greggdaug/RP_2port_VNA/README.md

# RP_2port_VNA
Documentation for Red Pitaya 2-port VNA / SDR tranceiver.
Matlab files are provided for 1-port cal and dut, and 2-port cal and dut. 2-port cal is under construction.
Word document contains original write-up submitted to QST.
Powerpoint document contains pictures for write-up.
