greggdaug/RP_2port_VNA/rp_vna_sdrxcvr_pics_072117.pptx

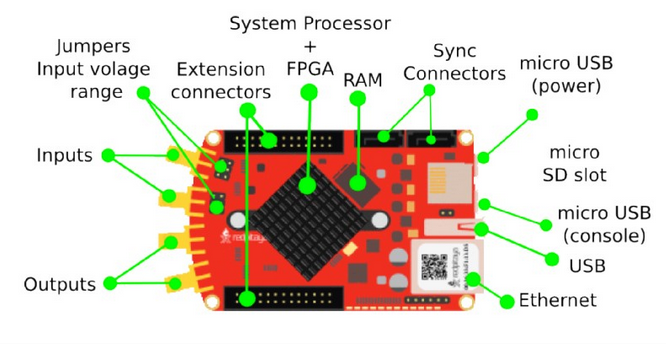
[picture p1: figure]

Figure 1 – Red Pitaya Components

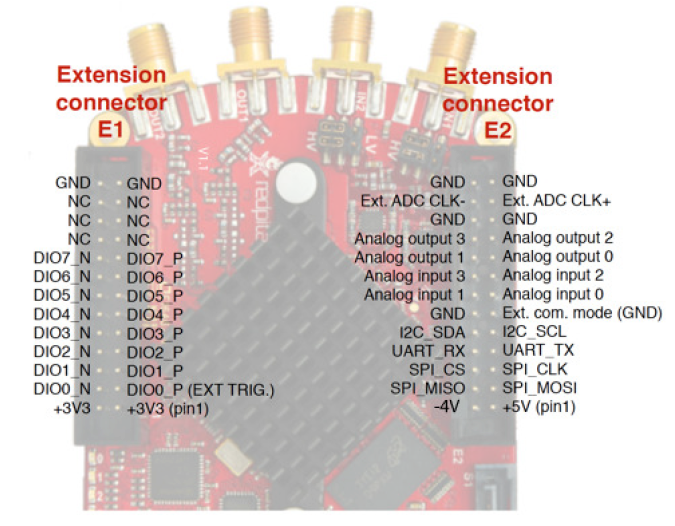
[picture p2: figure]

## Slide 2

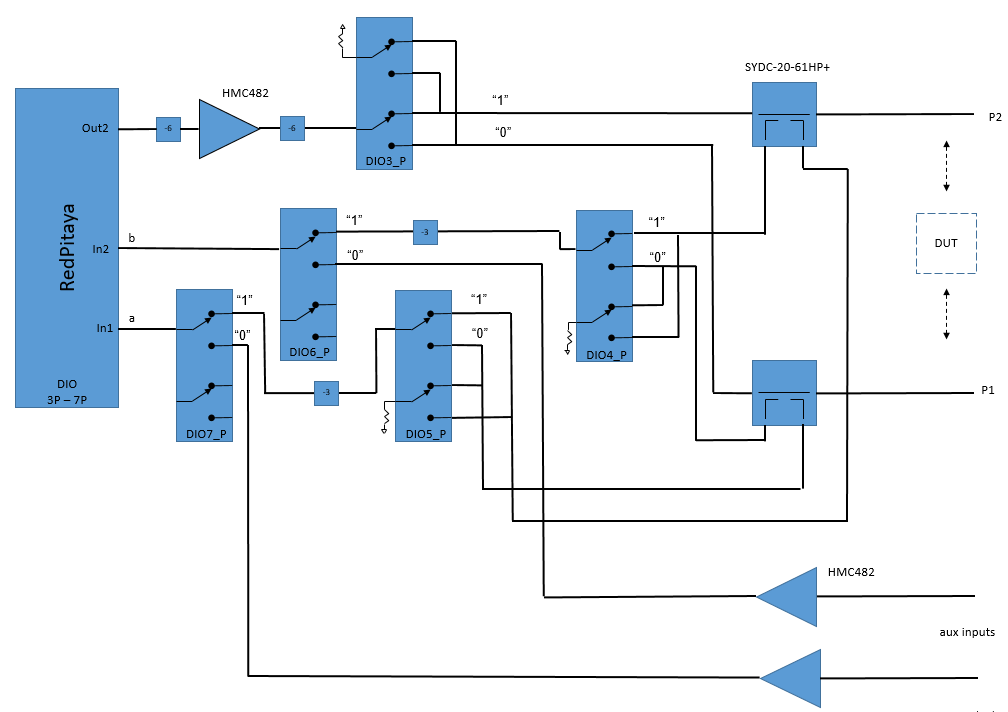
[picture p3: figure]

Figure 2 – VNA / Aux ADC Input PWB Block Diagram

## Slide 3

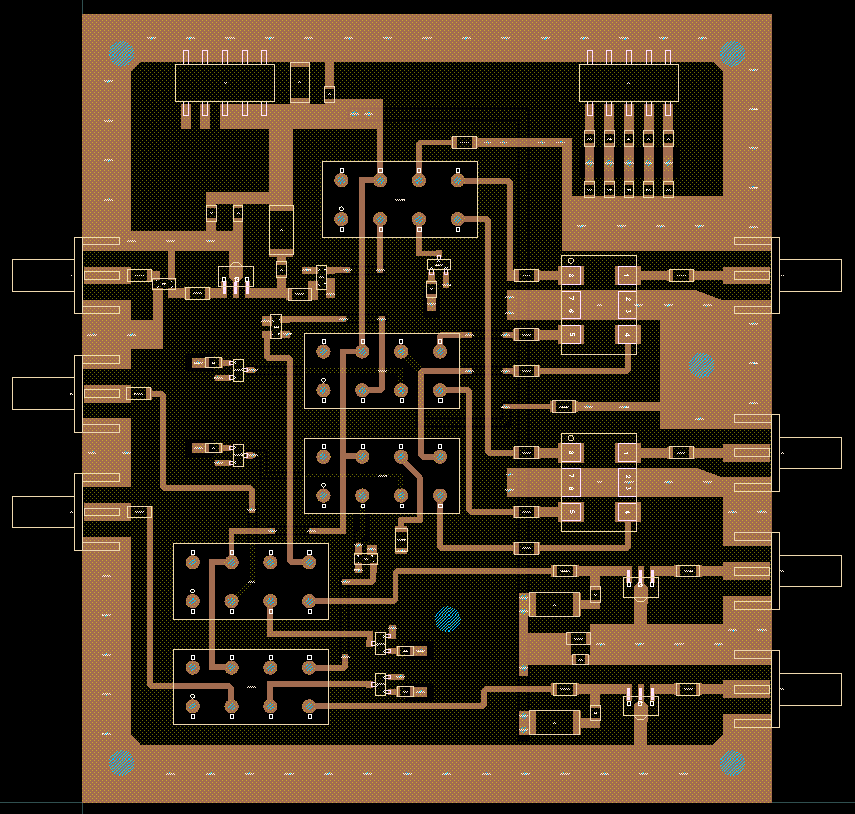
[picture p4: figure]
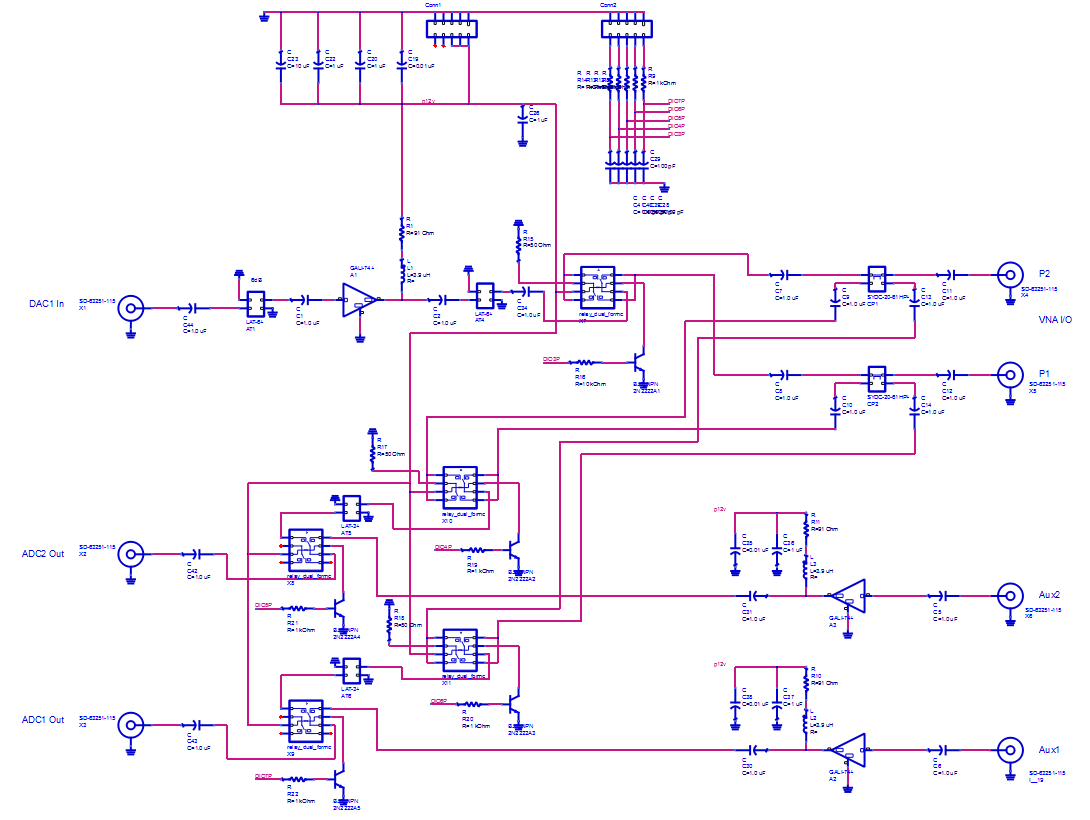
[picture p5: figure]

Figure 3 PWB Schematic / Layout

## Slide 4

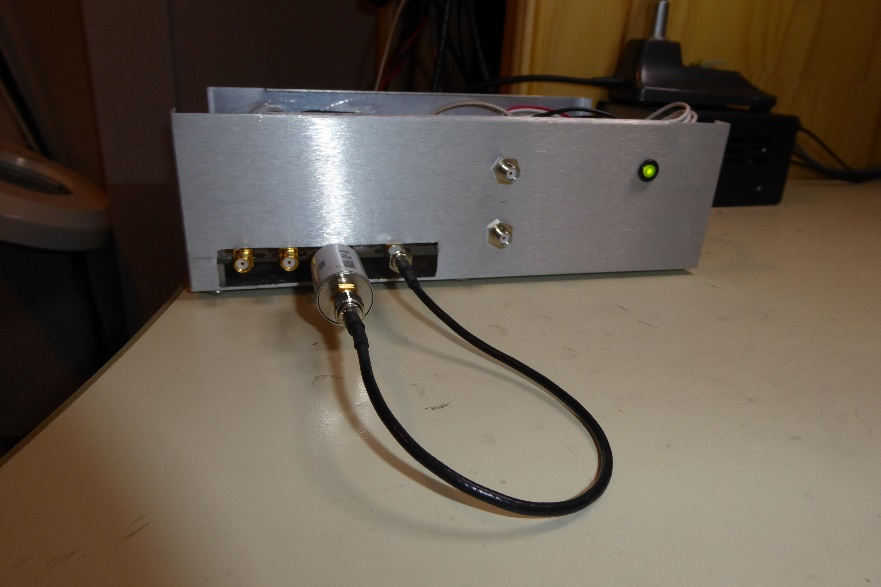
[picture p6: figure]
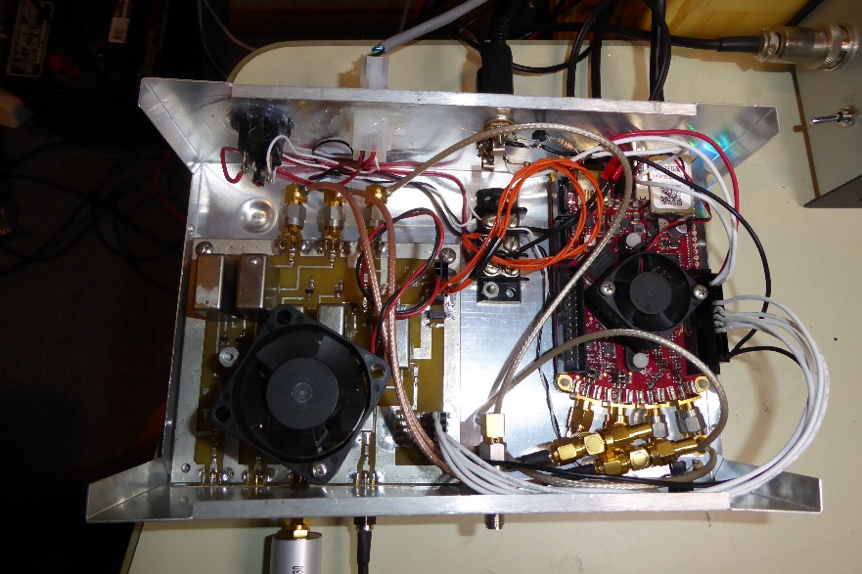
[picture p7: figure]

DAC1 Out

A1

A2

P1

P2

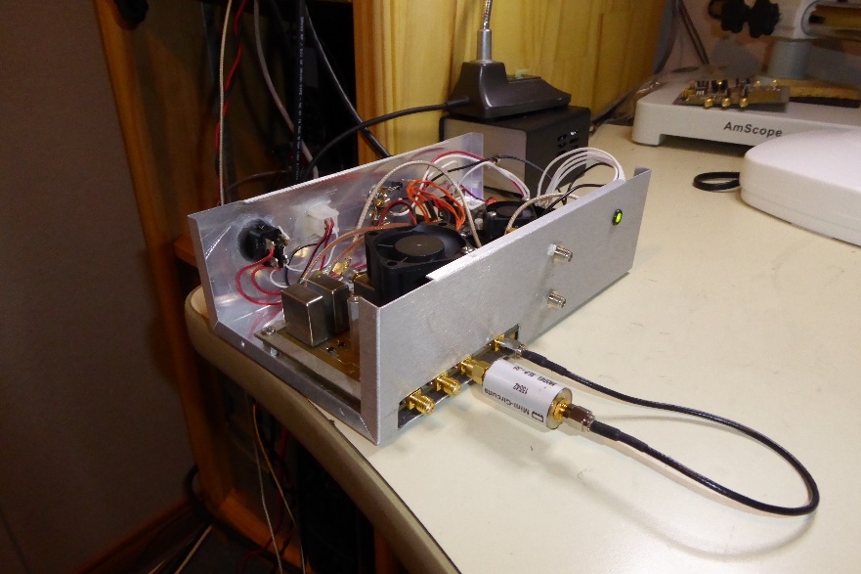
[picture p8: figure]
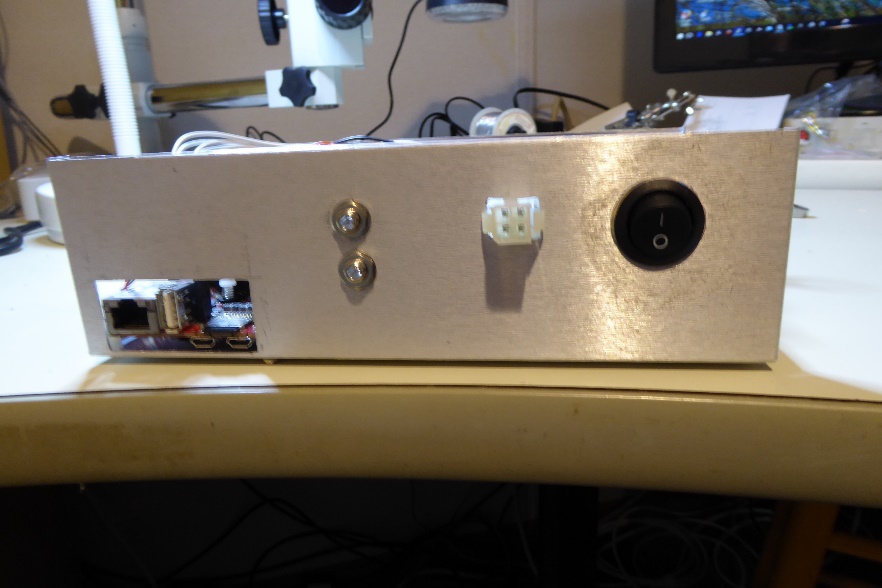
[picture p9: figure]

PTT In

RP I/O

PTT Out

+12V / +5V

Figure 4
Red Pitaya / PWB Enclosure

## Slide 5

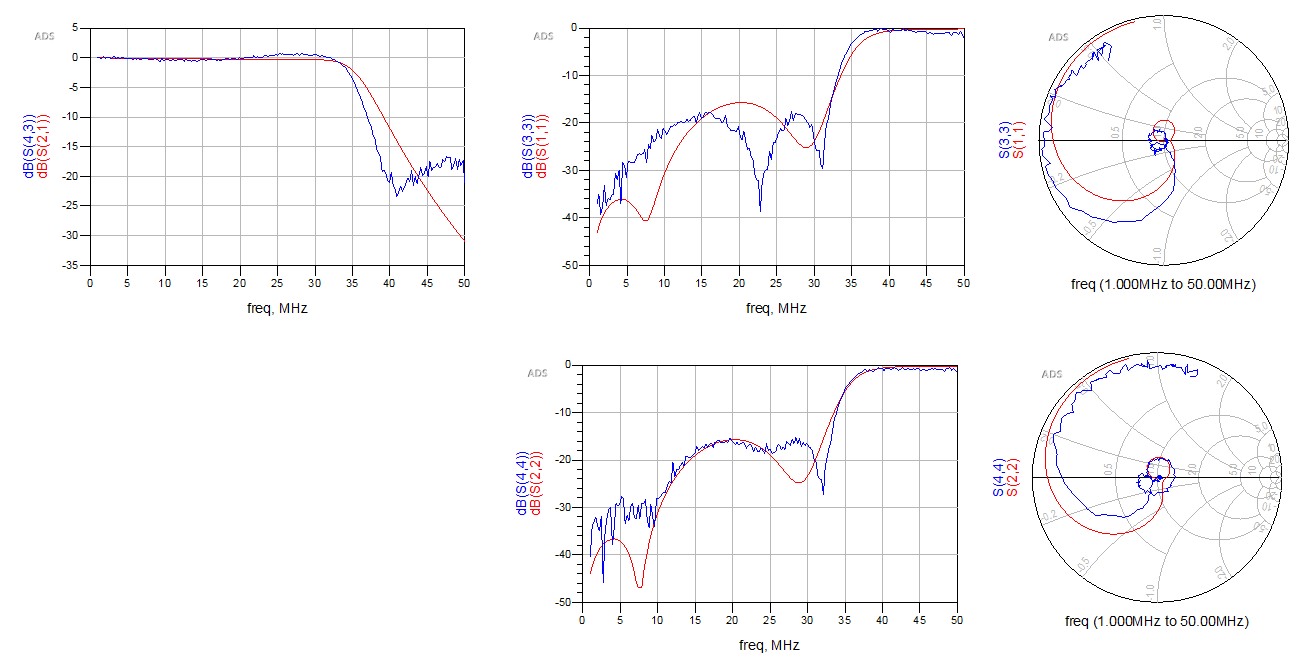
[picture p10: figure]

Figure 5
2-port VNA Example (MiniCircuits SLP-30 LPF)
Red = MiniCircuits s-parameters
Blue = RP VNA measured s-parameters

## Slide 6

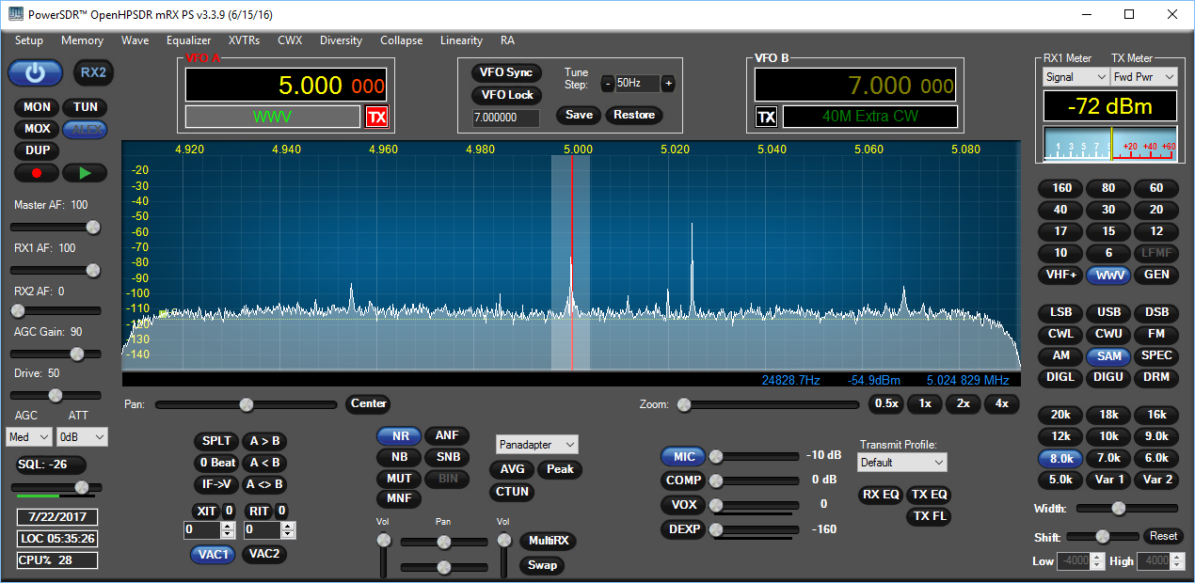
[picture p11: figure]

Figure 6
PowerSDR Application

## Slide 7

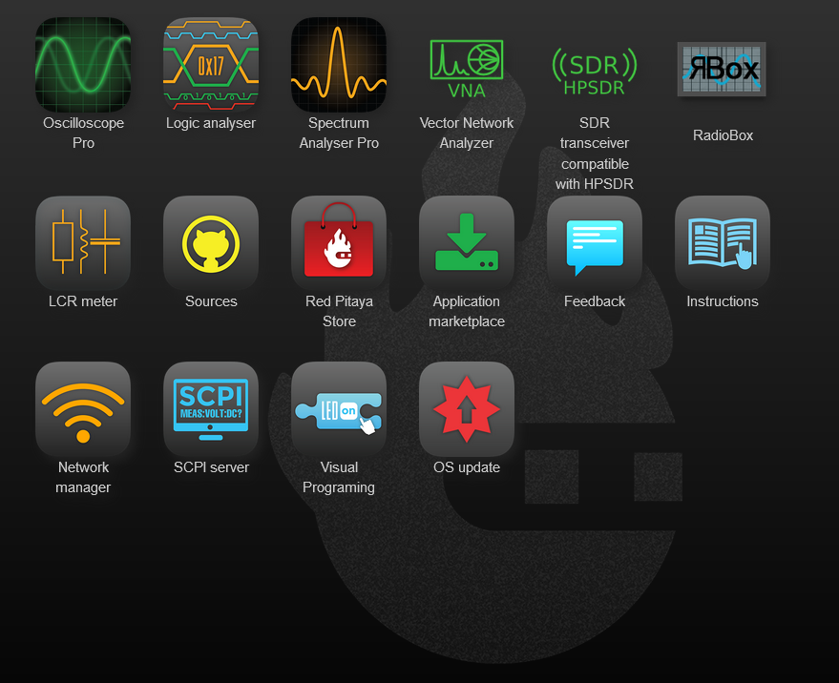
[picture p12: figure]
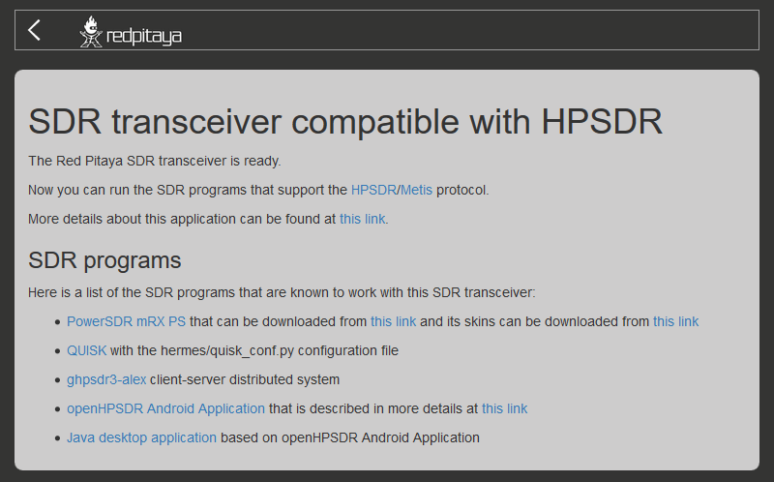
[picture p13: figure]

Figure 7
Red Pitaya Web Interface
